billmallard/MAOS-ICE/analysis/engine_phase1/h_quote_estimate_tables.md

| Part | First-op, qty 1 | First-op, qty 5 (each) | First-op marginal, NRE paid once | NRE per part number | Casting, qty 1 | Casting, qty 5 (each) | Printed sand |
|---|---|---|---|---|---|---|---|
| case half (pair = 2 part numbers) | $1,972-6,742 | $652-1,968 | $572-1,442 | $1,400-5,300 | $1,226-2,692 | $1,046-2,117 | $626-767 |
| cylinder-bank block (L = R, 1 part number) | $1,258-4,275 | $338-1,071 | $258-675 | $1,000-3,600 | $965-2,367 | $785-1,792 | $365-442 |
| bank head (mirrored L/R, 2 part numbers) | $2,233-7,940 | $685-2,314 | $533-1,690 | $1,700-6,250 | $887-2,275 | $707-1,700 | $287-350 |

Per engine (6 castings):
- first-op, first engine (all NRE on it): $9.8k-33.9k
- first-op, batch of 5 engines (NRE spread over 5): $3.1k-9.9k per engine
- first-op, NRE paid once by the program, batch of 5: $1.7k-4.6k per engine
- first-op NRE, whole program (CAM + fixtures): $7.2k-26.7k
- castings, first engine: $6.2k-14.7k
- castings, batch of 5 engines: $5.1k-11.2k per engine

Phase-1 model lines (member_200.py) for comparison: FIRST_OP $3.0k-12.0k; castings $4.4k-10.9k.
