billmallard/MAOS-ICE/analysis/engine_phase1/radiator_tables.md

MCP 134 kW; fuel 454 kW; coolant 109 kW; oil 23 kW.

| case | V (KIAS) | core depth (mm) | face velocity (m/s) | radiator face (cm^2) | oil cooler face (cm^2) | air (kg/s) | core dp (Pa) | cooling drag power (kW, % MCP) | installed system (kg) | kW per kg |
|---|---|---|---|---|---|---|---|---|---|---|
| SL ISA+20 | 70 | 50 | 8 | 2,891 | 884 | 3.46 | 347 | 1.7 (1.2 %) | 26.0 | 5.1 |
| SL ISA+20 | 80 | 32 | 6 | 4,378 | 1,047 | 3.73 | 159 | 1.1 (0.8 %) | 26.2 | 5.0 |
| SL ISA+20 | 80 | 32 | 8 | 3,657 | 884 | 4.16 | 246 | 1.7 (1.3 %) | 24.6 | 5.4 |
| SL ISA+20 | 80 | 32 | 10 | 3,199 | 780 | 4.56 | 345 | 2.4 (1.8 %) | 23.5 | 5.6 |
| SL ISA+20 | 80 | 32 | 12 | 2,877 | 706 | 4.92 | 454 | 3.3 (2.5 %) | 22.8 | 5.8 |
| SL ISA+20 | 80 | 50 | 6 | 3,522 | 1,047 | 3.14 | 225 | 1.1 (0.8 %) | 28.2 | 4.7 |
| SL ISA+20 | 80 | 50 | 8 | 2,891 | 884 | 3.46 | 347 | 1.7 (1.3 %) | 26.0 | 5.1 |
| SL ISA+20 | 80 | 50 | 10 | 2,495 | 780 | 3.75 | 486 | 2.5 (1.9 %) | 24.7 | 5.3 |
| SL ISA+20 | 80 | 50 | 12 | 2,221 | 706 | 4.02 | 640 | 3.6 (2.7 %) | 23.8 | 5.5 |
| SL ISA+20 | 80 | 64 | 6 | 3,182 | 1,047 | 2.91 | 272 | 1.2 (0.9 %) | 29.6 | 4.4 |
| SL ISA+20 | 80 | 64 | 8 | 2,583 | 884 | 3.18 | 420 | 1.8 (1.3 %) | 27.2 | 4.8 |
| SL ISA+20 | 80 | 64 | 10 | 2,211 | 780 | 3.43 | 588 | 2.7 (2.0 %) | 25.6 | 5.1 |
| SL ISA+20 | 80 | 64 | 12 | 1,956 | 706 | 3.66 | 774 | 4.0 (3.0 %) | 24.6 | 5.4 |
| SL ISA+20 | 90 | 50 | 8 | 2,891 | 884 | 3.46 | 347 | 1.8 (1.3 %) | 26.0 | 5.1 |
| 12,000 ft ISA+20 | 70 | 50 | 8 | 2,338 | 705 | 2.39 | 400 | 1.9 (1.4 %) | 24.1 | 5.5 |
| 12,000 ft ISA+20 | 80 | 32 | 6 | 3,517 | 839 | 2.57 | 184 | 1.2 (0.9 %) | 24.2 | 5.4 |
| 12,000 ft ISA+20 | 80 | 32 | 8 | 2,922 | 705 | 2.85 | 284 | 1.9 (1.4 %) | 22.9 | 5.8 |
| 12,000 ft ISA+20 | 80 | 32 | 10 | 2,545 | 619 | 3.11 | 397 | 2.7 (2.0 %) | 22.0 | 6.0 |
| 12,000 ft ISA+20 | 80 | 32 | 12 | 2,281 | 558 | 3.35 | 523 | 3.8 (2.8 %) | 21.4 | 6.2 |
| 12,000 ft ISA+20 | 80 | 50 | 6 | 2,867 | 839 | 2.19 | 259 | 1.3 (0.9 %) | 25.9 | 5.1 |
| 12,000 ft ISA+20 | 80 | 50 | 8 | 2,338 | 705 | 2.39 | 400 | 1.9 (1.4 %) | 24.1 | 5.5 |
| 12,000 ft ISA+20 | 80 | 50 | 10 | 2,009 | 619 | 2.58 | 560 | 2.9 (2.2 %) | 23.0 | 5.7 |
| 12,000 ft ISA+20 | 80 | 50 | 12 | 1,782 | 558 | 2.76 | 738 | 4.3 (3.2 %) | 22.3 | 5.9 |
| 12,000 ft ISA+20 | 80 | 64 | 6 | 2,611 | 839 | 2.04 | 313 | 1.3 (1.0 %) | 27.2 | 4.8 |
| 12,000 ft ISA+20 | 80 | 64 | 8 | 2,105 | 705 | 2.21 | 484 | 2.1 (1.5 %) | 25.1 | 5.2 |
| 12,000 ft ISA+20 | 80 | 64 | 10 | 1,793 | 619 | 2.37 | 677 | 3.2 (2.4 %) | 23.8 | 5.5 |
| 12,000 ft ISA+20 | 90 | 50 | 8 | 2,338 | 705 | 2.39 | 400 | 2.0 (1.5 %) | 24.1 | 5.5 |

Installed-system line items besides the cores (kg): engine-side coolant, 6 L of 50/50 6.4; hoses, clamps, fittings 2.5; two electric pumps (R-23), EWP115 class 2.0; expansion tank + cap + thermostat housing 1.2; oil lines and thermostat 1.0; ducts, mounts, flaps (sheet / printed) 3.0

SL ISA+20, 80 KIAS: installed system 22.8-29.6 kg across the depth/face-velocity grid; drag 0.8-3.0 % of MCP.
Design point (min of mass + 2 kg per kW of drag power): radiator 3,657 cm^2, oil cooler 884 cm^2, system 24.6 kg, drag 1.3 % MCP, 5.4 kW/kg, 0.030 kW/cm^2 radiator.
