billmallard/MAOS-ICE/analysis/engine_phase1/torsional_h_tables.md

## H flat-6, LS7 module, 3,300 rpm

| J_prop (kg m^2) | mode 1 / 2 / 3 (Hz) | major-order crossings in idle-105 % redline | redline major-order frequency | mode-1 margin above the top major order at redline |
|---|---|---|---|---|
| 0.6 | 266 / 770 / 1275 | mode 1 x order 6 at 2,664 rpm; mode 1 x order 9 at 1,776 rpm | 3: 165 Hz, 6: 330 Hz, 9: 495 Hz | 3: 1.61, 6: 0.81, 9: 0.54 |
| 1.0 | 261 / 768 / 1274 | mode 1 x order 6 at 2,610 rpm; mode 1 x order 9 at 1,740 rpm | 3: 165 Hz, 6: 330 Hz, 9: 495 Hz | 3: 1.58, 6: 0.79, 9: 0.53 |
| 1.5 | 258 / 767 / 1273 | mode 1 x order 6 at 2,583 rpm; mode 1 x order 9 at 1,722 rpm | 3: 165 Hz, 6: 330 Hz, 9: 495 Hz | 3: 1.57, 6: 0.78, 9: 0.52 |
| 2.5 | 256 / 766 / 1273 | mode 1 x order 6 at 2,560 rpm; mode 1 x order 9 at 1,707 rpm | 3: 165 Hz, 6: 330 Hz, 9: 495 Hz | 3: 1.55, 6: 0.78, 9: 0.52 |

Throw inertia 0.0103 kg m^2, throw stiffness 727,054 N m/rad, nose 892,245 N m/rad (ASSUMED).
Throw stiffness x0.7: J_prop 1.0 modes 225 / 665 / 1103 Hz
Throw stiffness x1.3: J_prop 1.0 modes 289 / 849 / 1413 Hz

## A flat-4, Lycoming 540 module, 2,750 rpm

| J_prop (kg m^2) | mode 1 / 2 / 3 (Hz) | major-order crossings in idle-105 % redline | redline major-order frequency | mode-1 margin above the top major order at redline |
|---|---|---|---|---|
| 0.6 | 301 / 843 / 1331 | mode 1 x order 8 at 2,259 rpm | 2: 92 Hz, 4: 183 Hz, 6: 275 Hz | 2: 3.29, 4: 1.64, 6: 1.10 |
| 1.0 | 295 / 841 / 1330 | mode 1 x order 8 at 2,213 rpm | 2: 92 Hz, 4: 183 Hz, 6: 275 Hz | 2: 3.22, 4: 1.61, 6: 1.07 |
| 1.5 | 292 / 840 / 1329 | mode 1 x order 8 at 2,189 rpm | 2: 92 Hz, 4: 183 Hz, 6: 275 Hz | 2: 3.18, 4: 1.59, 6: 1.06 |
| 2.5 | 289 / 839 / 1328 | mode 1 x order 8 at 2,170 rpm | 2: 92 Hz, 4: 183 Hz, 6: 275 Hz | 2: 3.16, 4: 1.58, 6: 1.05 |

Throw inertia 0.0159 kg m^2, throw stiffness 636,173 N m/rad, nose 892,245 N m/rad (ASSUMED).
Throw stiffness x0.7: J_prop 1.0 modes 257 / 735 / 1159 Hz
Throw stiffness x1.3: J_prop 1.0 modes 323 / 923 / 1471 Hz
