billmallard/MAOS-ICE/analysis/engine_phase0/tv_tables.md

| Case | J_prop reflected (kg m^2) | firing band (Hz) | soft: k below (N m/rad) | stiff: k above (N m/rad) |
|---|---|---|---|---|
| A direct, 4-cyl 200 hp, 2,750 rpm | 1.400 | 23 - 92 | 2,918 | 109,948 |
| A direct, 2-cyl 100 hp, 2,750 rpm | 0.900 | 13 - 46 | 578 | 16,660 |
| B geared 2.4:1, 8-cyl 200 hp, 5,800 rpm | 0.243 | 120 - 387 | 17,508 | 443,800 |
| C geared 2.0:1, 4-cyl 200 hp, 4,800 rpm | 0.400 | 50 - 160 | 5,831 | 145,766 |
| E geared 1.6:1, 6-cyl diesel 200 hp, 3,900 rpm | 0.625 | 50 - 195 | 9,571 | 355,390 |
| G geared 2.0:1, 4-rotor 200 hp, 4,600 rpm (1 pulse/rotor/rev) | 0.400 | 100 - 307 | 20,213 | 464,091 |
