billmallard/MAOS-ICE/docs/engine/sources/COMPARABLE_ENGINES_2026-10-16.md

# Comparable engines: ratings, mass, TBO, fuel, price (read 2026-10-16)

Source record for `REQUIREMENTS.md` and `ARCHITECTURES.md`. Every value was
read on 2026-10-16 from the source key given (list at the end). "nf" = not
found; it is not an estimate. Price is the weakest column: no current US
dealer price was found for the Rotax 912 iS, any UL Power engine, any Jabiru,
the O-200-D, the Austro engines or the SMA.

## Spark ignition

| Engine | Takeoff | Max continuous | cc | Dry mass (vendor definition) | TBO | Fuel | New price USD | Cooling |
|---|---|---|---|---|---|---|---|---|
| Rotax 912 ULS | 73.5 kW / 100 hp @5800, 5 min [R1][R3] | 69 kW @5500 [R3] | 1352 | 56.6 kg with gearbox [R1] | 2000 h [R2] | min RON 95 / AKI 91 (OM: ASTM D4814 min AKI 91); MON 85; E10 [R1][R3] | 26,497.87, Bert Flood (AU) [R7]* | liquid heads, air cylinders |
| Rotax 912 iS Sport | 73.5 kW / 100 hp @5800 [R4] | 72 kW @5500 [R4] | 1352 | 63.6 kg with gearbox [R4] | 2000 h [R4] | MON 85 / RON 95 / AKI 91, E10 [R4] | nf | liquid + air |
| Rotax 915 iS | 104 kW / 141 hp [R5] | 99 kW / 135 hp @5500 [R5] | 1352 | 82.2 kg incl. gearbox, turbo, intercooler, exhaust [R5] | **1200 h** [R5] | MON 85 / RON 95 / AKI 91, E10 [R5] | 51,590.77 ex-GST, Bert Flood [R7]* | liquid + air |
| Rotax 916 iS | 117 kW / 160 hp @5800 [R6] | 101 kW / 137 hp @5500 [R6] | 1352 | 85.8 kg incl. gearbox, turbo, intercooler, exhaust (~91.2 kg with frame, alternator) [R6] | 2000 h [R6] | as 915 | 59,380.54, Bert Flood [R7]* | liquid + air |
| UL Power UL260iS | 107 hp @3300 [U1] | "93 hp @2800" (not labelled continuous) [U1] | 2592 | 60.1 kg dry; 72.9 kg ready to fly [U1] | 2000 h / 12 yr [U5]+ | min 97 RON / 88 MON (=93 AKI); 100LL or UL91 allowed; ethanol not stated [U1] | "contact us" | ram air |
| UL350iS | 130 hp @3300 [U2] | 123 hp @2800 [U2] | 3503 | 66.1 kg incl. starter, generator, exhaust [U2] | as above | as above | "contact us" | ram air |
| UL390iS | 160 hp @3300 [U3] | 145 hp @2800 [U3] | 3900 | 85.3 kg dry / 100 kg RTF [U3] | as above | as above | "contact us" | ram air |
| UL520iS | 200 hp @3300 [U4] | 185 hp @2800 [U4] | 5254 | 93.3 kg dry / 108 kg RTF [U4] | as above | 97 RON / 88 MON [U4] | "contact us" | ram air |
| Jabiru 2200 Gen4 | 80 hp @3300 [J1] | nf | 2200 | 62.3 kg incl. exhaust, carb, starter, alternator, ignition [J1] | 2000 h, top end 1000 h [J3] | 100LL; MOGAS above 95 RON (AKI 90) at listed serials; no alcohol in fibreglass tanks [J3] | nf | ram air |
| Jabiru 3300 Gen4 | 120 hp @3300 [J2] | 3300 rpm max continuous [J3] | 3300 | 83.5 kg, same inclusions [J2] | 2000 h [J3] | as 2200 | nf | ram air |
| Jabiru 5100 | 180 hp [J4] | nf | 5077 | 117 kg incl. exhaust, carbs, starter, alternator [J4] | nf | nf | nf | air |
| Continental O-200-D | 100 hp @2750 [C1] | nf | 3292 | 89.3 kg typical incl. all accessories [C1] | 2200 h / 12 yr [C1] | 100/100LL | nf | air |
| Lycoming O-360-A1A | 180 hp @2700 [L1] | nf | 5916 | 131.5 kg incl. carb, mags, harness, baffles, starter, alternator [L1] | 2600 h new / 2000 h overhauled / 12 yr (SI 1009BF, 2026-07-20) [L3] | min 100/100LL [L1] | O-360-A1F6 87,668 + 30,000 core, Air Power [L4] | air |
| Lycoming IO-540-K1A5 | 300 hp @2700 [L2] | nf | 8870 | 212.7 kg [L2] | 2600 / 2000 h / 12 yr [L3] | not extracted | 124,826 + 36,000 core, Air Power [L5] | air |
| Continental IO-550-D | 300 hp @2700 [C2] | nf | 9046 | 209.4 kg typical incl. all accessories [C2] | 1900 h / 12 yr [C2] | 100/100LL | 67,578 + 22,000 core, Air Power [C4] | air |
| Viking 130 | 130 hp @5400 crank / 2400 prop, 2.33:1 [V1] | nf | 1500 | 99.8 kg, contents not defined [V1] | nf | "89+ octane", scale not stated [V1] | 15,000 (no radiator or exhaust) [V3] | liquid |
| Viking 195T | 195 hp @5400 [V2] | nf | 1500 turbo | 117.9 kg [V2] | nf | "91+ octane" [V2] | 24,000 [V4] | liquid + intercooler |
| Aeromomentum AM15 | 120 hp @5800 / 2240 prop, 2.588:1 [A1] | nf | 1497 | 83.9 kg [A1] | 2000 h [A1] | 90 AKI standard, 93 AKI high power; E10 [A3] | 13,000-14,100 incl. gearbox, starter, alternator, ECU [A1] | liquid |
| Aeromomentum AM20T | 260 hp @5800 (300 hp @6200, 5 min) [A2] | nf | 1998 | 129.3 kg [A2] | 1800 h [A2] | nf | 27,995 (300 hp: 29,700) [A2] | liquid |

\* Bert Flood (Australia) prices from controller.com search snippets; listing pages returned 403 and could not be opened. Treat as leads, converted currency not stated.
\+ UL Power serials >= 250000; below that 1500 h / 12 yr.

## Diesel / Jet-A

| Engine | Takeoff | Max continuous | cc | Dry mass | TBO/TBR | Fuel | Price USD | Cooling |
|---|---|---|---|---|---|---|---|---|
| Continental CD-135 | 133 hp @3900 crank (~2300 prop) [D3][D4] | nf | 1991 | 134 kg incl. gearbox, turbo, FADEC [D3] | 2100 h / 12 yr [D4] | Jet A, A-1, JP-8, EN 590 [D4] | nf | liquid |
| Continental CD-155 | 153 hp @3900 / 2300 prop [D1] | nf | 1991 | 134 kg [D1] | 2100 h / 12 yr [D1] | as CD-135 | 47,515 list (2018, AOPA) [D11] | liquid |
| Austro AE300 | 168 hp @3880 / 2300 prop [D6] | 168 hp [D7] | 1991 | 185 kg (TCDS) [D6] | 1800 h [D8] | Jet A/A-1; EN 590 with SB [D6] | nf | liquid |
| Austro AE330 | 180 hp @3880 [D6] | 171 hp @3720 [D6] | 1991 | 185 kg [D6] | 1800 h [D9] | Jet only [D6] | nf | liquid |
| DeltaHawk DHK180 | 180 hp @2600, direct [D12] | 180 hp [D12] | ~3300 | 151 kg est. (2024 sheet) / ~162 kg (2023 sheet), incl. starter, alternator, turbo, exhaust [D12][D2] | nf | Jet A/A-1; JP-5, JP-8, #2 diesel [D12] | 60,000 target (Kitplanes) [D13] | liquid |
| DeltaHawk DHK235 | 235 hp @2600 [D12] | 235 hp [D12] | ~3300 | 151 kg est. [D12] | nf | as DHK180 | nf | liquid |
| SMA SR305-230 | 227 hp @2200 [D14] | 227 hp [D14] | 4988 | 195 kg [D14] | 2400 h (AvWeb) [D15] | Jet A/A-1, TS-1 [D14] | nf | air/oil |

Rotax inspection interval: 100 h or 12 months, from an owner-forum post citing the Rotax line maintenance manual [R8], not the manual itself.

## E15 and pump octane

EPA defines E15 as 10.5-15 % ethanol, approved only for 2001-and-newer cars and light trucks and flex-fuel vehicles [E1]. Summer sale (June 1 - Sept 15) still runs on emergency waivers; 2026 was the fifth year (waivers 2026-03-25 and 2026-05-19) [E2][E3]. Year-round E15 is not law: the House passed H.R. 1346 in May 2026 (218-203); no Senate passage found [E3][E4]. ASTM D4814 does not cap oxygenate content in its scope and carries antiknock guidance (seasonal, altitude) in Appendix X1 [E5]. ASTM D2699 states the antiknock index (RON+MON)/2 "in accordance with Specification D4814" is what is "posted on retail dispensing pumps in the U.S." [E6]. The 87/89/91/93 grade ladder was not verified from a primary source (the D4814 appendix is paywalled).

## Sources

- R1 https://www.flyrotax.com/products/912-uls-s
- R2 https://www.flyrotax.com/assets/files/products/Datasheet-Aircraft-Engine-Rotax-912ULS.pdf
- R3 https://www.rotax-owner.com/pdf/OM_912-Series_ED4_R1.pdf
- R4 https://www.flyrotax.com/products/912-is-sport-isc-sport
- R5 https://flyrotax.com/products/915-is-a-isc-a
- R6 https://www.flyrotax.com/products/916-is-c
- R7 https://www.controller.com/listing/for-sale/259472071/ ; /259472127/ ; /259472141/
- R8 https://rotax-owner.com/en/912is-technical-questions/8866-annual-oil-change-interval
- U1-U4 https://ulpower.com/en/engines/ul260/ul260is ; /ul350/ul350is ; /ul390/ul390is ; /ul520/ul520is
- U5 https://ulpower.com/en/engines/faq/ulpower-engine-tbo
- J1 https://jabiru.aero/2200-gen4/
- J2 https://jabiru.aero/3300-gen4/
- J3 https://jabiru.aero/wp-content/uploads/2025/03/JEM0002-12-29-Aug-2024-1.pdf
- J4 https://en.wikipedia.org/wiki/Jabiru_5100
- C1 https://continental.aero/wp-content/uploads/2026/03/Continental-specsheet-Avgas-200-Engine-Series-v1_WEB.pdf
- C2 https://continental.aero/wp-content/uploads/2026/03/Continental-specsheet-Avgas-550-Engine-Series-v4_WEB.pdf
- C4 https://www.airpowerinc.com/io-550-d
- L1 https://chapters.eaa.org/eaa245/-/media/3B5A3308519148D58C389A05AEEC001F.ashx (Lycoming OM 60297-12)
- L2 https://chapters.eaa.org/eaa245/-/media/B6BE8FE56A774FAFB6060D9475FE9FEA.ashx (OM 60297-10)
- L3 https://www.lycoming.com/sites/default/files/file/2026-07/SI1009BF_%20TBO_Schedule.pdf
- L4 https://www.airpowerinc.com/enpl-rt9529
- L5 https://www.airpowerinc.com/enpl-rt8679
- V1-V4 https://www.vikingaircraftengines.com/viking-130-engine ; /viking-195-turbo-engine ; /new-products/viking-130-hp-engines ; /new-products/viking-195-hp-turbocharged-engines
- A1 https://aeromomentum.com/am15-117hp-to-147hp/
- A2 https://aeromomentum.com/am20t-230hp-300hp/
- A3 https://aeromomentum.com/wp-content/uploads/2022/07/AM13-and-AM15-Engine-Installation-Manual-V2.pdf
- D1 https://continental.aero/wp-content/uploads/2026/03/Continental-specsheet-JetA-CD155-Engine-Series-v5_WEB.pdf
- D2 https://www.deltahawk.com/wp-content/uploads/2024/02/DHE23008-Specification-Sheet.GA-Market.V2.07.11.23.pdf
- D3 https://www.easa.europa.eu/en/downloads/7707/en
- D4 https://continental.aero/cd-135/
- D6 https://www.easa.europa.eu/en/downloads/7617/en
- D7 https://diamondaircraft.com/fileadmin/diamondaircraft/products/austro-engine/AE_E4_Series_Factsheet_screen.pdf
- D8 https://www.diamondaircraft.com/en/about-diamond/newsroom/news/article/austro-engine-ae300-receives-easa-certificate-for-1800-hour-tbo/
- D9 https://www.diamondaircraft.com/en/about-diamond/newsroom/news/article/austro-engine-ae330-receives-easa-certificate-for-1800-hour-tbo/
- D11 https://aopa.org/news-and-media/all-news/2018/may/16/continental-explains-factory-skyhawk-diesel-plan
- D12 https://deltahawk.com/wp-content/uploads/2024/09/SpecSheetBackREV.pdf
- D13 https://www.kitplanes.com/?p=194039
- D14 https://www.easa.europa.eu/en/downloads/7673/en
- D15 https://avweb.com/?p=121998
- E1 https://afdc.energy.gov/fuels/ethanol-e15
- E2 https://www.dtnpf.com/agriculture/web/ag/crops/article/2026/03/25/e15-approved-summer-epa-waiver-fuel
- E3 https://www.everycrsreport.com/files/2026-06-05_IN10979_eb05420c575483e6a2de62d125ad6e62798010f6.html
- E4 https://ethanolrfa.org/media-and-news/category/news-releases/article/2026/05/rfa-applauds-house-passage-of-year-round-e15-legislation
- E5 https://eshop.normservis.sk/norma/astm-d4814-16-1.1.2016.html
- E6 https://store.astm.org/d2699-25.html
