billmallard/MAOS-ICE/analysis/engine_crank/sweep_200hp.png

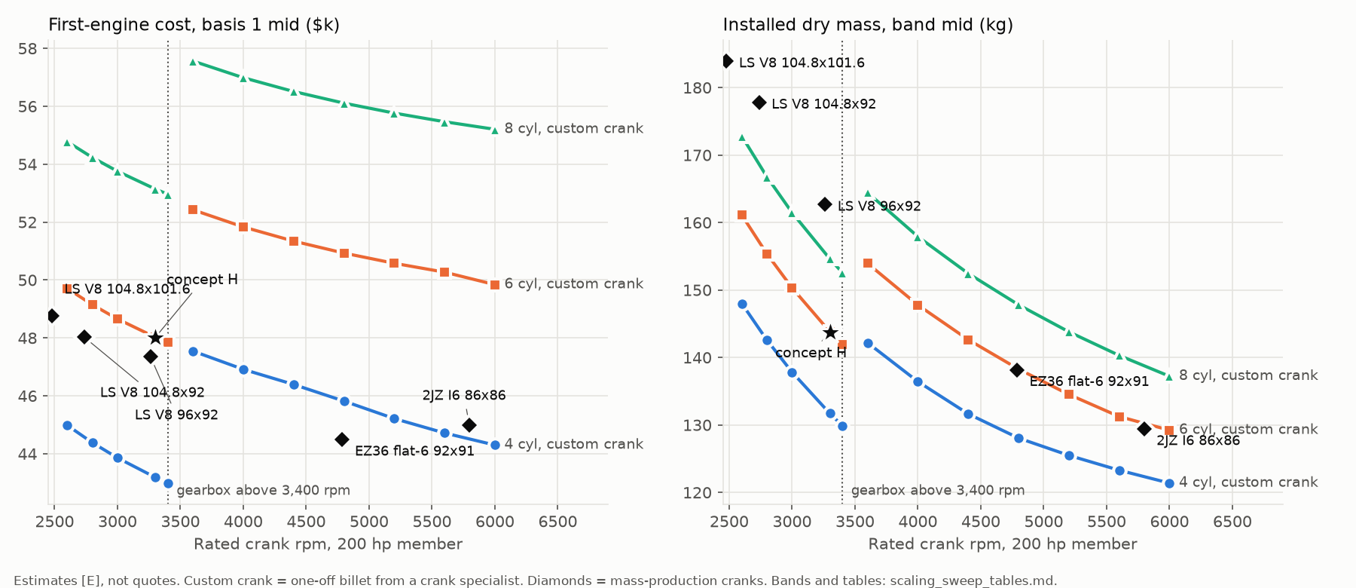
analysis/engine_crank/sweep_200hp.png
