billmallard/MAOS-ICE/cad/concept_h/H-101_views.png

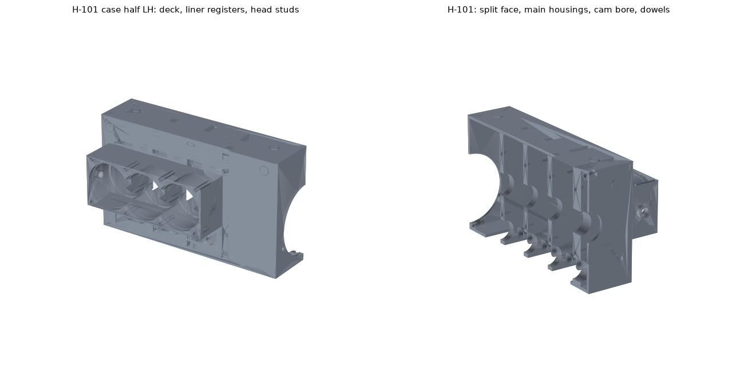
cad/concept_h/H-101_views.png
