billmallard/MAOS-ICE/cad/concept_h/H-201.step

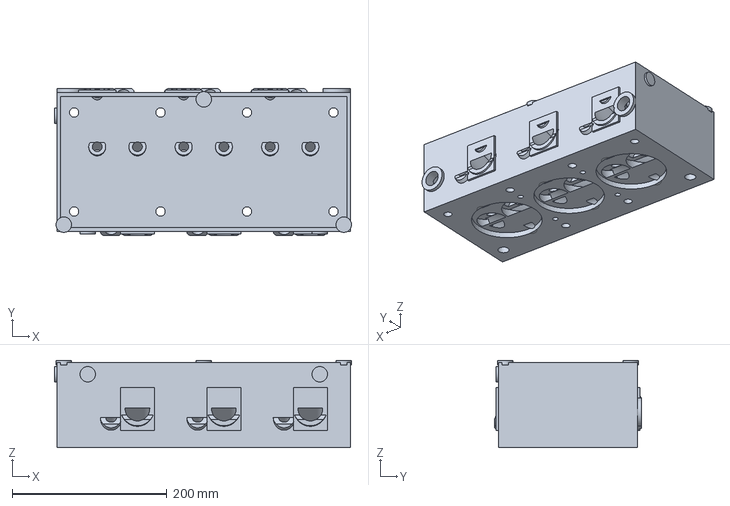
[picture p3: CAD file, 2026-10-29]
cad/concept_h/H-201.step
384.0 x 190.0 x 113.0 mm
