billmallard/MAOS-ICE/(commit log)

2026-04-17 Enhance motorcycle engine generator coupling section and introduce two-mission framework for hybrid architecture
2026-04-17 Voltage added to matrix
2026-04-20 Add ECU candidate matrix with redundancy architecture and Viking lessons
    Documents MegaSquirt MS3-Pro, SDS EM-6, and Speeduino as Hayabusa engine
    management candidates for generator-duty operation. Includes ECU warm-standby
    failover design, crank trigger fallback chain, and Section 5.3 — lessons
    derived from Viking Aircraft Engines documented ECU failure patterns covering
    shared power conditioning, output switching SPF, per-output protection, and
    harness design requirements.
2026-07-24 Add AantFarm TA65 turboalternator evaluation (Oshkosh 2026)
    Evaluates the TA65-1 recuperated turboalternator (60 kW electric, 30 kg,
    Jet A) against MAOS requirements. Single unit is disqualified for the 1G
    role: 60% of the 100 kW continuous floor at SL and ~40% of FL180 cruise
    electric demand due to ~1.4 kVA/1,000 ft altitude lapse. A 3x multi-genset
    installation closes cruise with margin at Rotax-path generator-side mass
    with real generation redundancy and near-zero cooling drag, at ~+40% fuel
    burn and unknown cost on an in-development product. Disposition: watchlist
    with vendor evidence gates. Adds matrix rows to the downselect and
    candidate matrix pointing at the full evaluation.
    Co-Auth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
2026-08-09 Add powertrain trade study: integrated combo scorecard toward $50k
    Reconciles the ICE power requirement (75 kW stale figure vs. the
    mission-traceable 96-155 kW envelope), catalogs 8 integrated
    ICE+generator+battery+motor combinations against the 1G+1B+2M
    architecture, scores each on cost/performance/safety, and downselects
    to a turbo-Hayabusa budget combo pending a bench endurance evidence
    gate and SAFETY consult (AER-62).
2026-08-09 Fold SAFETY ruling (AER-62) into powertrain trade study
    Applies SAFETY's closed consult to the v1 scorecard: an interim
    continuous-duty derate for zero-sustained-duty-data engines (Hayabusa,
    Kawasaki H2) caps their credited continuous output below the 96 kW
    floor, which re-derives Performance (not just Safety) for Combos 3-6.
    Also applies the LFP-baseline chemistry ruling across every combo (not
    just the cost-motivated lead one), the revised ECU failure-severity
    classification (Hazardous-conditional, not "not an emergency"), and
    reframes the DES-INT-001 second architecture from Combo 4 (shares
    Combo 3's ICE risk) to Combo 1 (architecturally independent of it).
    Lead recommendation (Combo 3) i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
2026-08-09 Add v2 used/salvage re-score to powertrain trade study (AER-65)
    Bill's ruling on the four AER-56 calls (whole-powertrain scope, used/
    salvage permitted, bench test deferred) turns the prior iterate into
    this pass. Adds a two-column (new vs. used/salvage) price re-score for
    every priceable combo, tests Bill's used-Hayabusa/used-Tesla-drive-unit
    hypothesis directly (the Tesla-DU half doesn't hold up as a cost lever
    even used, due to the mandatory $2,699 T-2C VCU tax; the broader
    used/salvage-electric-side lever does, narrowly), and opens a new
    SAFETY consult (AER-67) on salvage-battery provenance rather than
    pricing that line as risk-free. Lead combo (Combo 3) and the bench-
    endurance evidence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
2026-08-09 Add v3: widen ICE sourcing to China/Russia/E.Europe + Donut motor row (AER-65 R3)
    Catalogs five non-Western engine candidates (Zongshen CA550T, Chinese
    automotive 1.5T turbo class, Verner 9V, Vedeneyev M14P, Anhui Haery
    Lark HFE) with sourcing/support risk as an explicit column, prices two
    new combos (Zongshen, Verner) that don't beat Combo 3, and disqualifies
    or flags-unsourceable the Russian and military-UAV rows on their own
    merits rather than excluding them outright. Adds the Donut Labs
    ring/hub motor as an unscored watchlist candidate, grounding the
    "claims not credible until independently supported" caution in that
    company's own VTT-tested battery product rather than asserting it.
    Lea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
2026-08-09 Name aftermarket BMS candidates for salvage-pack re-hosting (AER-67/AER-59)
    SAFETY's AER-67 ruling credits zero capacity toward the verified 40 kWh
    reserve until a named aftermarket BMS is bench-validated for protection
    limits, active balancing, and comms/watchdog fail-safe behavior. Adds
    §9.8: three candidates (Orion BMS 2, Elithion Lithiumate, Batrium)
    against that exact spec surface, with price and integration-risk notes.
    Desk research only, no bench spend. Surfaces that true active balancing
    does not appear to exist off-the-shelf at our ~100S series count in this
    market - flagged for SAFETY rather than silently substituting passive.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
2026-08-10 Add corrected Combo-3 electric-machine kill-gate + DG-004 re-derivation (AER-73)
    Screens EMRAX 268, H3X HPDM-180/250, and paralleled Hyper9 as replacements
    for the disqualified NetGain HyPer9 HV selection (AER-68 sec7.1-7.2). EMRAX
    268 (MV winding, combined cooling) passes: 117kW continuous clears the 96kW
    generator floor, 2x clears the 155kW climb floor, at $94,050 total / 634kg
    installed (-14% vs the disqualified selection). Re-derives DG-004 to ~700V
    nominal with sourced switchgear (TE Connectivity Kilovac/Hartman), pending
    Systems concurrence. Rank-scoring against Combo 1 is explicitly deferred
    pending Bill's disposition on AER-56.
2026-08-11 Score Edge Performance Rotax conversions as generator ICE candidate
    Evaluates Edge Performance AS's EP912STi (154 HP/182 Nm peak, turbo
    Rotax 912ULS conversion) and product line as a generator prime-mover
    against the pinned AER-57 envelope (96 kW cruise / 155 kW climb),
    comparing against the corrected (EMRAX 268-based, AER-73) Combo 3
    rather than the stale Hyper9-based $55,990 figure the original combo
    carried before AER-68 disqualified that electric-machine selection.
    Findings: no manufacturer continuous rating exists for any Edge
    model; applying SAFETY's existing interim derate (AER-62) credits
    57.4 kW against the 96 kW floor, a larger shortfall than Hayabusa's
    already-known gap. Integrat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
2026-08-11 Combo-3 price-vs-capability frontier: single-motor lever + used/salvage columns (AER-73)
    Reframes the corrected Combo-3 electric-machine selection (PR #16) from a
    pass/fail $50k gate to a price-vs-capability frontier per Bill's 2026-08-11
    requirement update (R1'), and adds a single-propulsion-motor package (R4)
    alongside the existing twin-EMRAX-268 baseline.
    Three packages x two cost bases:
    - Twin EMRAX 268 (unchanged architecture): $85,250 new / $57,200 used
    - Single EMRAX 348 (R4 lever, pending AER-81): $78,650 new / $50,600 used
    - Single EMRAX 268 (capability-reduced, 25% short on max climb): $66,550 new / $47,850 used
2026-08-11 Apply AER-81 SAFETY ruling; correct EMRAX 348 continuous power (162->145 kW)
    AER-81 ruled: bare single winding-set/single-inverter motor is not
    admissible; redundancy must come from a dual-wound motor with
    independent inverter channels or two physically separate motor+inverter
    units (R1-R5). Applied package-by-package:
    - Package A (twin EMRAX 268) already satisfies R1(b) per AER-69's
    finding that it's two physically separate motor+inverter units.
    Added R3 (motor-out clears cruise, not climb) and flagged R5
    common-cause items as unconfirmed.
    - Package B (single EMRAX 348): re-pulled the manufacturer's v1.6
    datasheet and position-parsed the table (the flattened-text
    extraction had m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
2026-08-30 AER-59 weekly market watch (2026-08-30): H3X HPDM-250 continuous rating resolved, Evolito E800 new lead, DeltaHawk first pricing signal
    - Resolves the HPDM-250 open item from the 2026-08-23 pass: H3X's own
    post states 180 kW as continuous shaft power at 18.7 kg (9.6 kW/kg),
    clearing the 155 kW climb floor in one unit. Still no public price.
    - Adds Evolito E800 (110 kW continuous / 28.3 kg, CAA type-cert
    submitted 2026-07-20 for Electra EL9) as a new tracked candidate.
    Unpriced; action item to request a quote.
    - Surfaces the first concrete DeltaHawk pricing signal ($110k-$125k
    for a DHK180/200 firewall-forward kit, forum-sourced, not an
    official quote) -- confirms Combo 7 reads at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
2026-09-05 Add genset package interface spec v0 (AER-609)
    Engine-agnostic ICD for the coupling, coolant, CAN/control, and fault
    semantics around a mass-produced core, per propulsion_reset.md §4 and
    Bill's stated interest in a genset package around a mass-produced core.
    Speed-matches candidate generator machines against core RPM, maps a
    seven-core shortlist onto the interface with ORG-003 credited power,
    bounds coolant/charge-air heat rejection from first principles, and
    closes the open turbo-fault-detection action item from AER-62.
2026-09-05 Propulsion reset: three architectures on mission metrics (AER-608)
    Re-derives cruise/climb power and MTOW as a closed loop per ORG-003
    (MTOW is an output, not the struck 2,600 lb input) for a direct-drive
    pusher (A0, benchmark), an in-line parallel hybrid (A1), and the
    corrected series hybrid (A2). A0 closes on paper; A1 closes only with
    a bigger-than-assumed ICE once its own mass is honestly counted; A2
    does not close on any currently-catalogued core, independent of
    battery chemistry or the open safety questions - the series
    architecture's own mass drives cruise power past what any priced,
    ORG-003-creditable genset core can sustain.
    Adds a candidate-core catalogue (Rotax 916 iS, Viking 195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
2026-09-05 Address SAFETY AER-610 closure conditions P1-P4 in reset doc
    Sources EMRAX 228's own datasheet for boost-motor mass/continuous power
    (superseding the EMRAX-268 mass-ratio EXTRAP), recomputes A1's climb
    margin, computes ICE-alone climb margin for a boost-motor-out case,
    confirms no FIT-rate data exists industry-wide for this motor class,
    and scopes the powered-descent reserve claim between clean-fault and
    shaft-seizure cases pending child issues to STRUCTURES and SYSTEMS.
2026-09-06 Fold STRUCTURES' AER-609 mount/envelope finding into A2 (v1.2)
    STRUCTURES reviewed GENSET_PACKAGE_SPEC_V0.md against its own AER-69
    mount/load-path work and found no genset core has ever been sited in
    CAD, and the one real envelope (boom-root nacelle, sized for twin
    propulsion motors at 60.8 kg) is 2.1x-3.7x undersized for a genset
    core plus cooling, with two unscoped load cases (isolated mount,
    firewall). This is a second, independent reason A2 does not close,
    on top of the power-closure gap already found in this document --
    even a hypothetical core big enough to close on power still has
    nowhere sited to go.
    No numeric changes to A0, A1, or the candidate catalogue.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
2026-09-06 Genset spec V0.1: correct mount siting, record DG-004 concurrence (AER-609)
    STRUCTURES (AER-670) and SYSTEMS (AER-669) reviewed the merged genset
    package ICD (PR #20). This corrects the two factual issues their reviews
    raised and carries the rest forward as named open items rather than
    silently redesigning around them:
    - Mount datum row overstated AER-69 v2: the boom-root CAD envelope is
    sited for the propulsion motors (60.8 kg twin-EMRAX-268 package), not
    an ICE or generator. No station has ever been sited for the genset
    core. Corrected in the consumed-inputs table, §1's envelope row, and
    Open Issue #2, which now also carries the 2.1x-3.7x mass/load-case
    mismatch STRUCTURES flag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
2026-09-13 Propulsion reset v1.3: source Turbotech TG-R90 mass/power (AER-59 weekly)
    Weekly market-watch pass finds the TG-R90 gap flagged 2026-09-06 (mass and
    price both unpublished) is half-closed: vendor's own site now gives a real
    OEM-continuous rating (85 kW/unit) and bare mass (64 kg/unit). Two units
    bound lighter and out-power the AM20T ICE+belt+generator line on a better
    evidence class -- the first core in this catalog to close A2's power gap on
    paper. Not a re-score: price and BSFC/fuel-consumption data remain
    unpublished, and BSFC in particular could erase the mass gain once run
    through the fixed-point MTOW/fuel solve. Also folds in a DeltaHawk pricing
    evidence upgrade (company-published vs.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
2026-10-16 Add dated source records for comparable engines and prop/drive hardware (AER-3320)
2026-10-16 Add phase-0 engine, prop-match, torsional and cost floor scripts with outputs (AER-3320)
2026-10-16 Add nine unranked drive and propeller-match options (AER-3320)
2026-10-16 Seed engine failure ledger and index the engine docs folder (AER-3320)
2026-10-16 Record Bill's phase-0 card rulings in engine requirements (AER-3320)
    Auto gas first, 200 hp first at <= $22k / $30k, MCP to 12,000 ft and
    takeoff to 8,000 ft, two cylinder sizes allowed. Unruled lines (R-8 diesel
    boost, 100 hp cost target) stay proposed.
2026-10-16 Add knock-limited compression ratio model calibrated on five engines (AER-3326)
2026-10-16 Match and rank drive and propeller options at 3,300 rpm (AER-3326)
2026-10-16 Narrow R-38, record the cost finding, extend the failure ledger (AER-3326)
2026-10-16 Commit MANUFACTURING envelope v1 and its concept H estimator (AER-3329)
    Envelope v1 (AER-3328) adds section 9, bottom-up first-op and casting
    estimates for concept H's six castings, liner and crank, and section 10,
    normalizing hardware sourcing. Committed as MANUFACTURING delivered it.
    h_quote_estimate.py is its script, with one fix: two print calls whose
    newline escape was lost in transit. Output matches envelope 9.2 and 9.3.
2026-10-16 Re-cost the 200 hp member on envelope v1, both cost bases (AER-3329)
    cost_v1.py replaces the lines envelope v1 section 9.7 re-estimates
    (first-op, castings, crank, liners, normalizing, machine shop) for
    concept H as sent, H with DFM items 1 and 4, and concept A, on the
    builder basis (batch of 5, NRE paid once) and the first-engine basis.
    A's Lycoming 540 pistons are priced from Aircraft Spruce as a separate
    line. H's low end rises from $23.2k to $26.7k (builder) and $35.8k
    (first engine); no variant meets $22k at its low end on either basis.
2026-10-16 Model turbo versus supercharger normalizing for concept H (AER-3329)
    1-D duty, turbine back-pressure and fixed-ratio supercharger boost
    across 0-12,000 ft, on the envelope v1 hardware (GT2860RS class,
    Rotrex C30-94). With the ground-adjustable propeller the supercharger's
    boost follows crank rpm and leaves 74 % of 200 hp in a 12,000 ft
    climb, against 94 % for the turbo; the turbo's back-pressure is a
    pumping gain at altitude and 1-2 % at sea level.
2026-10-16 Record F-5 as a miss and extend the failure ledger (AER-3329)
    F-5 now carries the v1 cost floor on both bases and is marked escalated.
    R-37's basis notes concept H at about 148-158 kg on sourced parts.
    FL-30 to FL-32 cover the turbo normalizer; FL-33 to FL-37 are
    MANUFACTURING's build-quality items MFG-1 to MFG-5.
2026-10-16 Cost concept H's casting set after the DFM rulings, on both bases (AER-3331)
    castings_h.py reruns MANUFACTURING's estimator on four castings and three
    part numbers (bank merged into each case half, one head part number on a
    4-axis second setup), using the coarse STEP boxes. It reproduces cost_v1.py's
    H-as-sent row before changing anything, then removes the machine-shop
    double count (bore/hone, balance and valve work carried twice). Also: the
    scrap the merge adds, liner mass like-for-like, gallery size, HMC swing.
2026-10-16 Rule on envelope 9.5 and the liner, and publish the drawing rules (AER-3331)
    Accepts the bank merge, the one-setup case pair, one head part number and
    the 4-axis head (without forcing both ports onto one face). Keeps the
    Darton MID wet liner, and corrects phase 1b's dry-sleeve saving from 6-7 kg
    to 2.9-4.1 kg once the sleeve's aluminium wall is counted.
2026-10-16 Restate F-5 on both cost bases and add the merged-case failures (AER-3331)
    F-5 now names each figure's basis: first engine carrying all NRE, or each
    of five with the NRE paid once. FL-38 (coolant into oil through the merged
    case) and FL-39 (head jacket plug) added; FL-34 reworded.
2026-10-18 Record crank, gearbox and Rotrex sources read 2026-10-18 (AER-3411)
2026-10-18 Sweep the 200 hp member from small-fast to large-slow with crank and gearbox priced (AER-3411)
2026-10-18 Rerun the drive ranking with the gearbox scored as proven-class (AER-3411)
2026-10-18 Add FL-40 to FL-49 for the crank routes, gearbox and supercharger (AER-3411)
